TUOVAProject/tuova-iot/docs/architecture.png

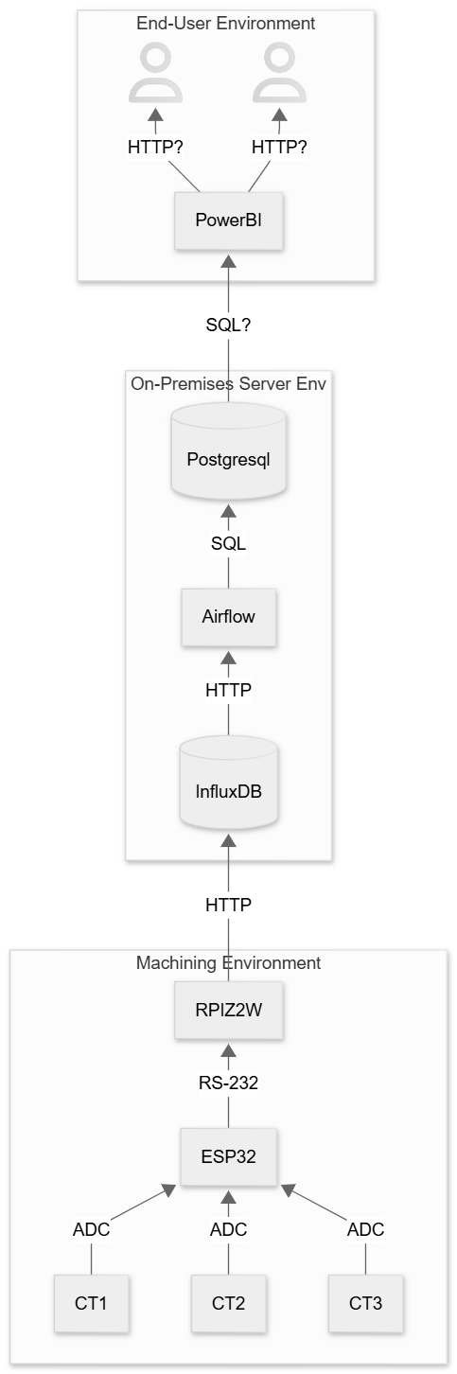
docs/architecture.png
