TUOVAProject/tuova-iot/(commit log)

2026-02-06 Fix esp32 linking
2026-07-23 Update schematics
2026-07-30 Fix whoops and terminology
    [esp32.ino]
